simple-ee/Power_CircuitDesigns/Ideal Diode (LM5051 version)/20240805_Projects_Ideal_Diode_LM5051_version_01.jpg

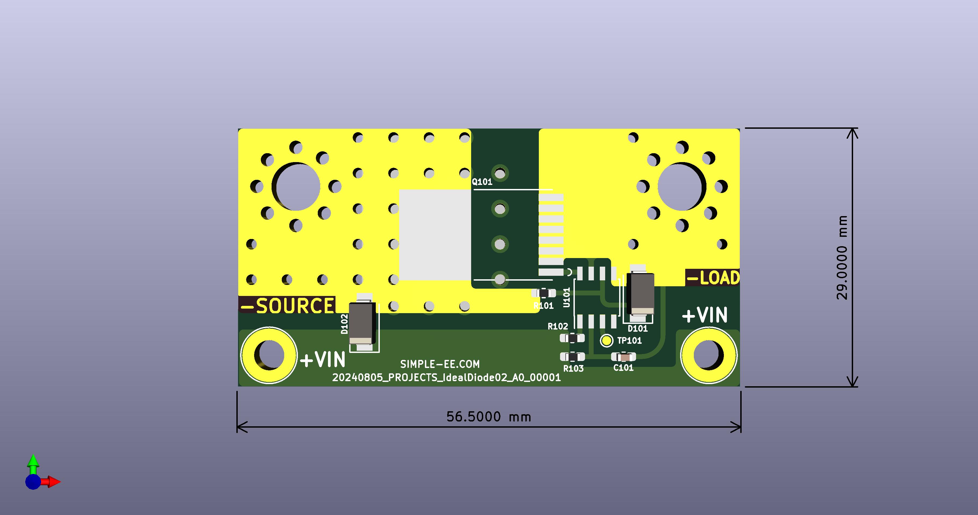
Ideal Diode (LM5051 version)/20240805_Projects_Ideal_Diode_LM5051_version_01.jpg
