simple-ee/Power_CircuitDesigns/Ideal Diode/2021_Project_OCP_Ideal_DiodeFront.jpg

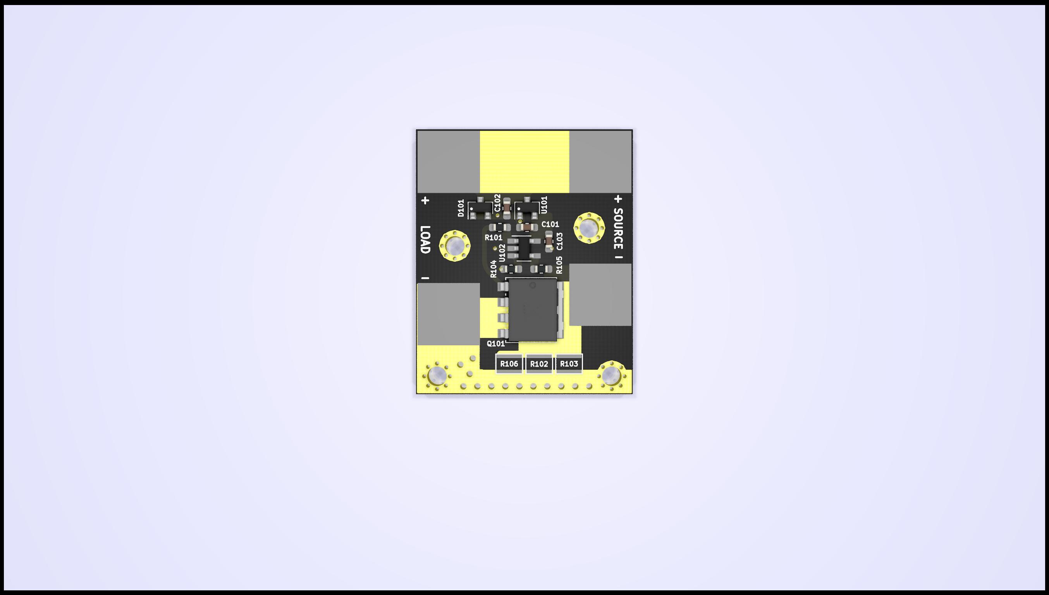
Ideal Diode/2021_Project_OCP_Ideal_DiodeFront.jpg
