simple-ee/Power_CircuitDesigns/Ideal Diode (LM5051 version)/Source Files/20220727_Projects_Ideal_Diode_02.step

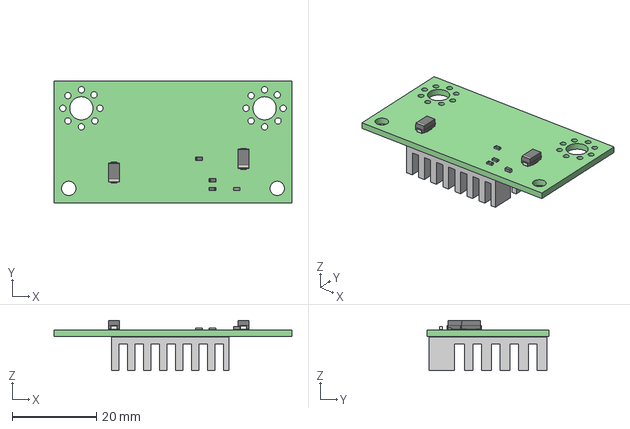
[picture p3: CAD file, 2024-08-06]
Ideal Diode (LM5051 version)/Source Files/20220727_Projects_Ideal_Diode_02.step
56.5 x 29.0 x 11.9 mm
20220727_Projects_Ideal_Diode_02 PCB
