simple-ee/Power_CircuitDesigns/Ideal Diode/Schematic_Gerber/2021_Project_OCP_Ideal_Diode_A4.pdf

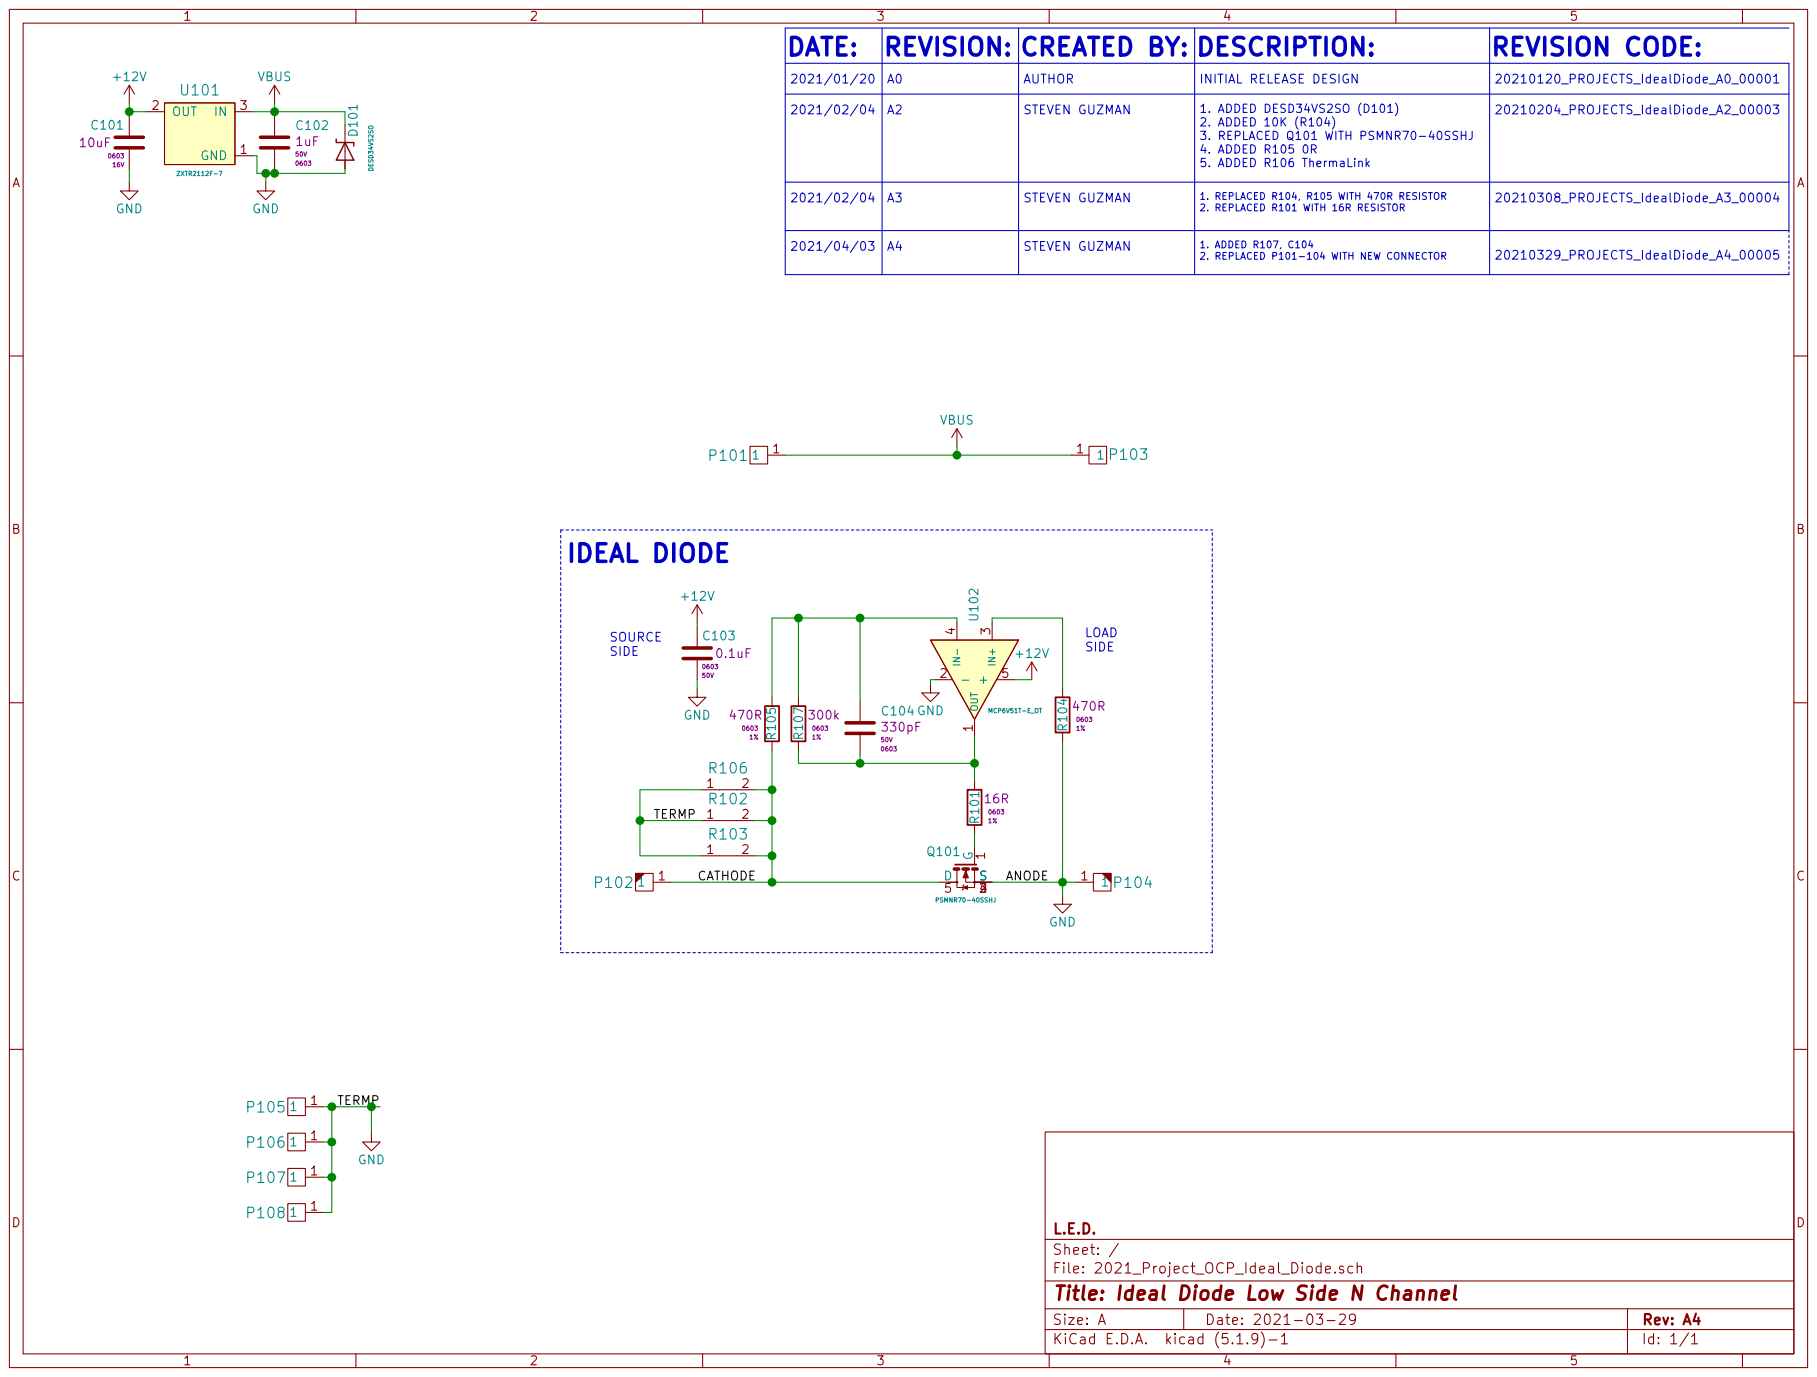
[picture p4: page 1]

2. REPLACED P101-104 WITH NEW CONNECTOR 1. ADDED DESD34VS2SO (D101) 2. ADDED 10K (R104) 3. REPLACED Q101 WITH PSMNR70-40SSHJ 4. ADDED R105 0R 5. ADDED R106 ThermaLink | 20210329_PROJECTS_IdealDiode_A4_00005 A0 20210120_PROJECTS_IdealDiode_A0_00001 STEVEN GUZMAN

AUTHOR | INITIAL RELEASE DESIGN

2021/02/04 | A3 | STEVEN GUZMAN | 1. REPLACED R104, R105 WITH 470R RESISTOR 2. REPLACED R101 WITH 16R RESISTOR | 20210308_PROJECTS_IdealDiode_A3_00004

2021/04/03 | A4 | | 1. ADDED R107, C104

Id: 1/1 Title: Ideal Diode Low Side N Channel
