simple-ee/Power_CircuitDesigns/Ideal Diode/Schematic_Gerber/2021_Project_OCP_Ideal_Diode_A3.pdf

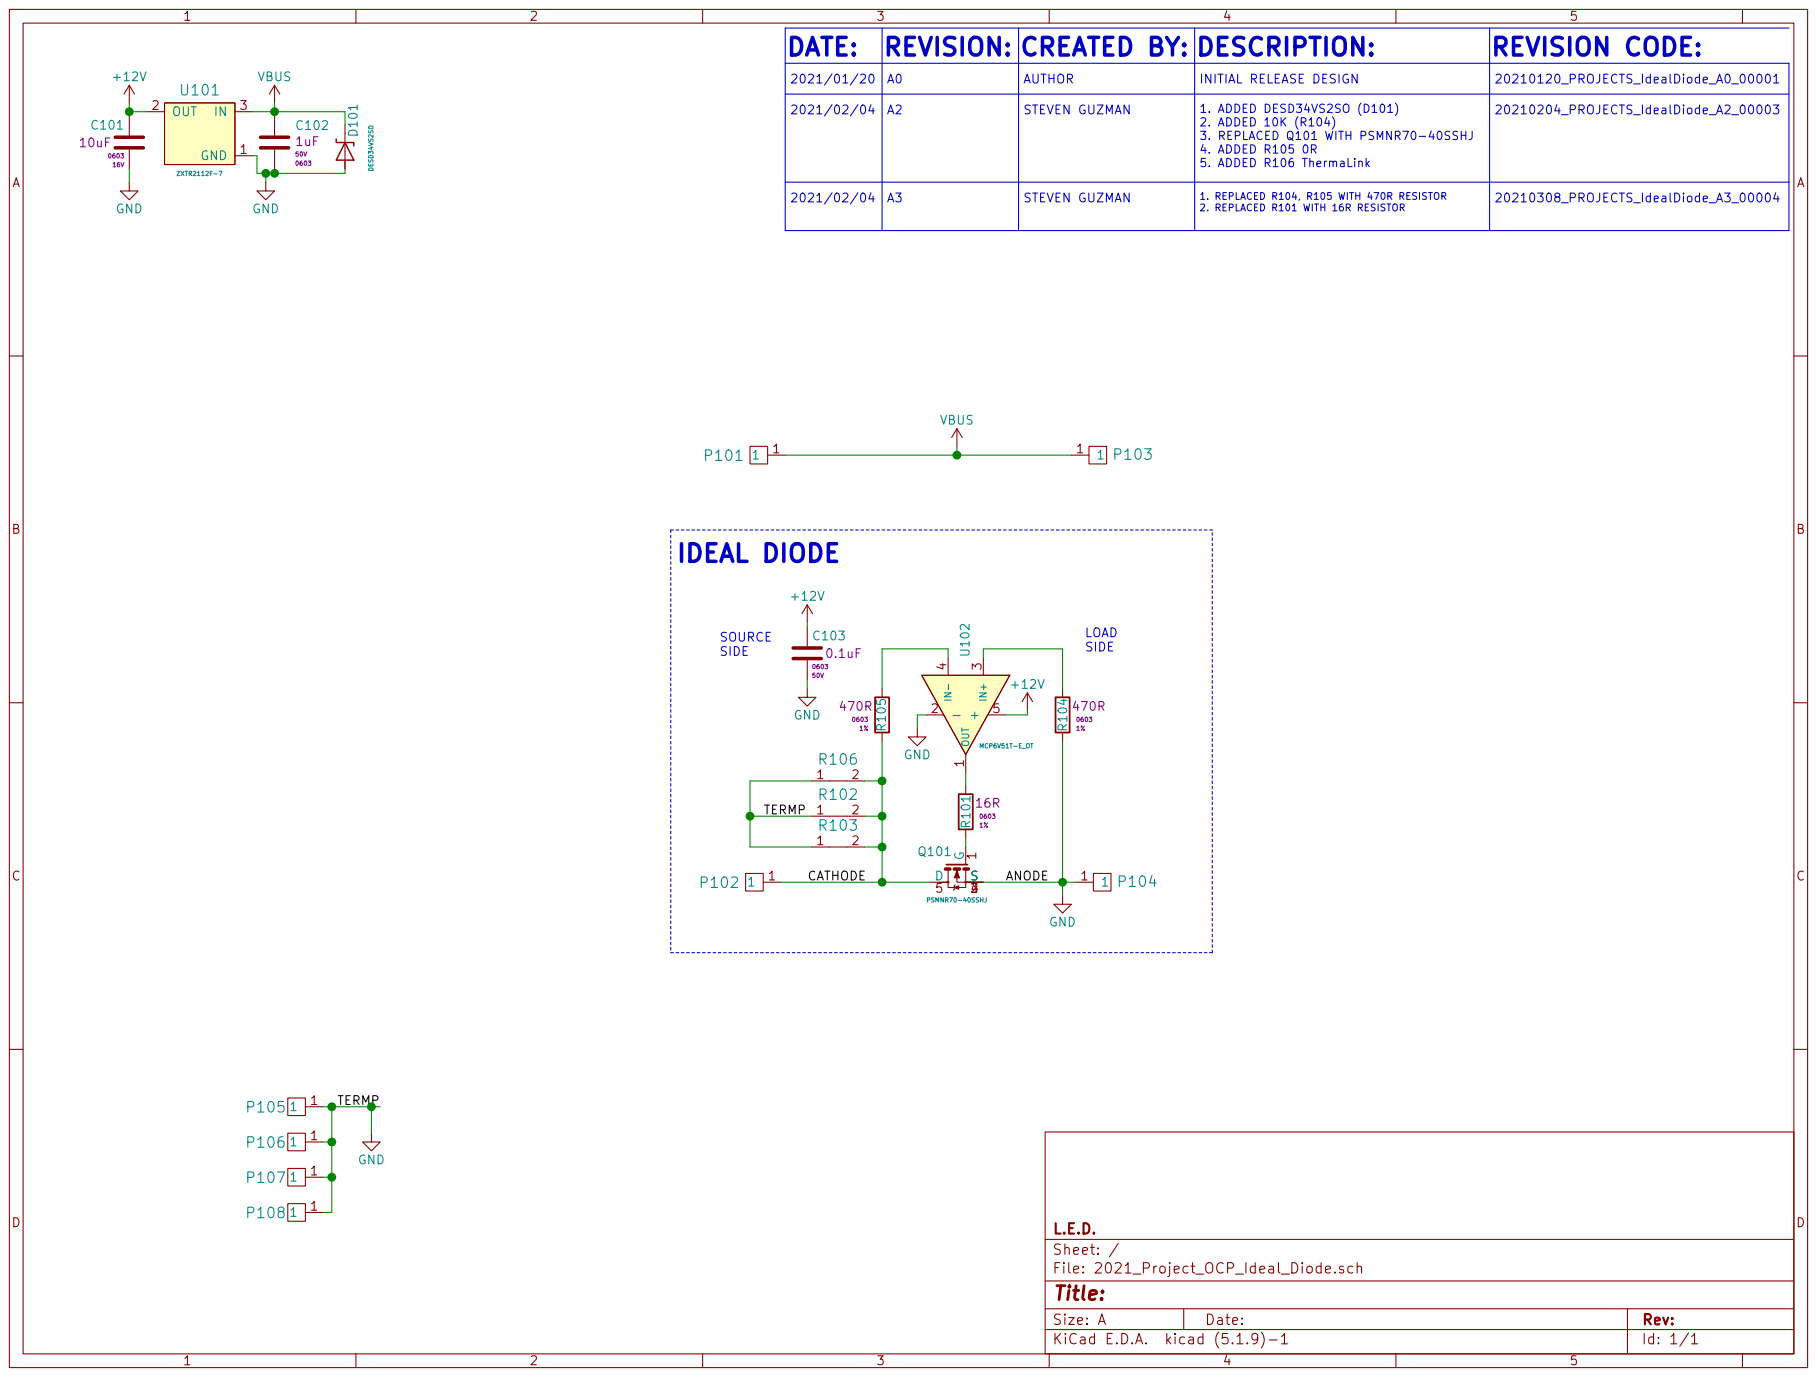
[picture p5: page 1]

REVISION: | STEVEN GUZMAN | DESCRIPTION: A3 INITIAL RELEASE DESIGN | REVISION CODE: 20210308_PROJECTS_IdealDiode_A3_00004 DATE:

2021/02/04 | A2 | | 2. REPLACED R101 WITH 16R RESISTOR STEVEN GUZMAN 1. ADDED DESD34VS2SO (D101) 2. ADDED 10K (R104) 3. REPLACED Q101 WITH PSMNR70-40SSHJ 4. ADDED R105 0R | 20210204_PROJECTS_IdealDiode_A2_00003

5. ADDED R106 ThermaLink IDEAL DIODE

1. REPLACED R104, R105 WITH 470R RESISTOR
