simple-ee/Power_CircuitDesigns/Ideal Diode (LM5051 version)/20240805_Projects_Ideal_Diode_LM5051_version_01.pdf

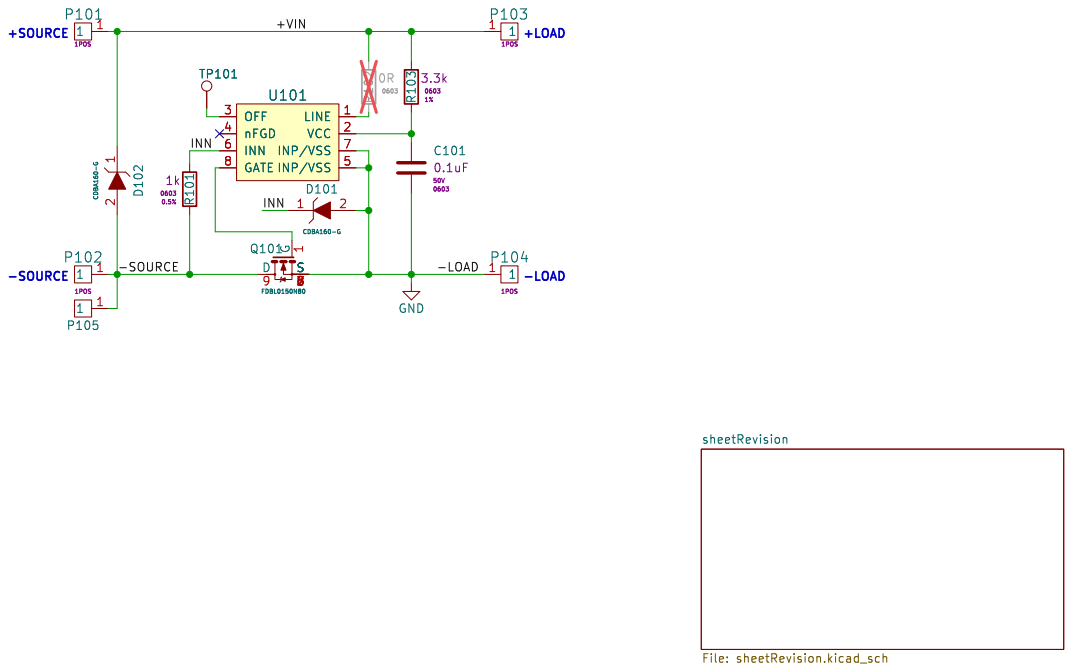
[picture p6: page 1]

Id: 1/2 Title: File: 20220727_Projects_Ideal_Diode_02.kicad_sch Sheet: / simple-ee.com

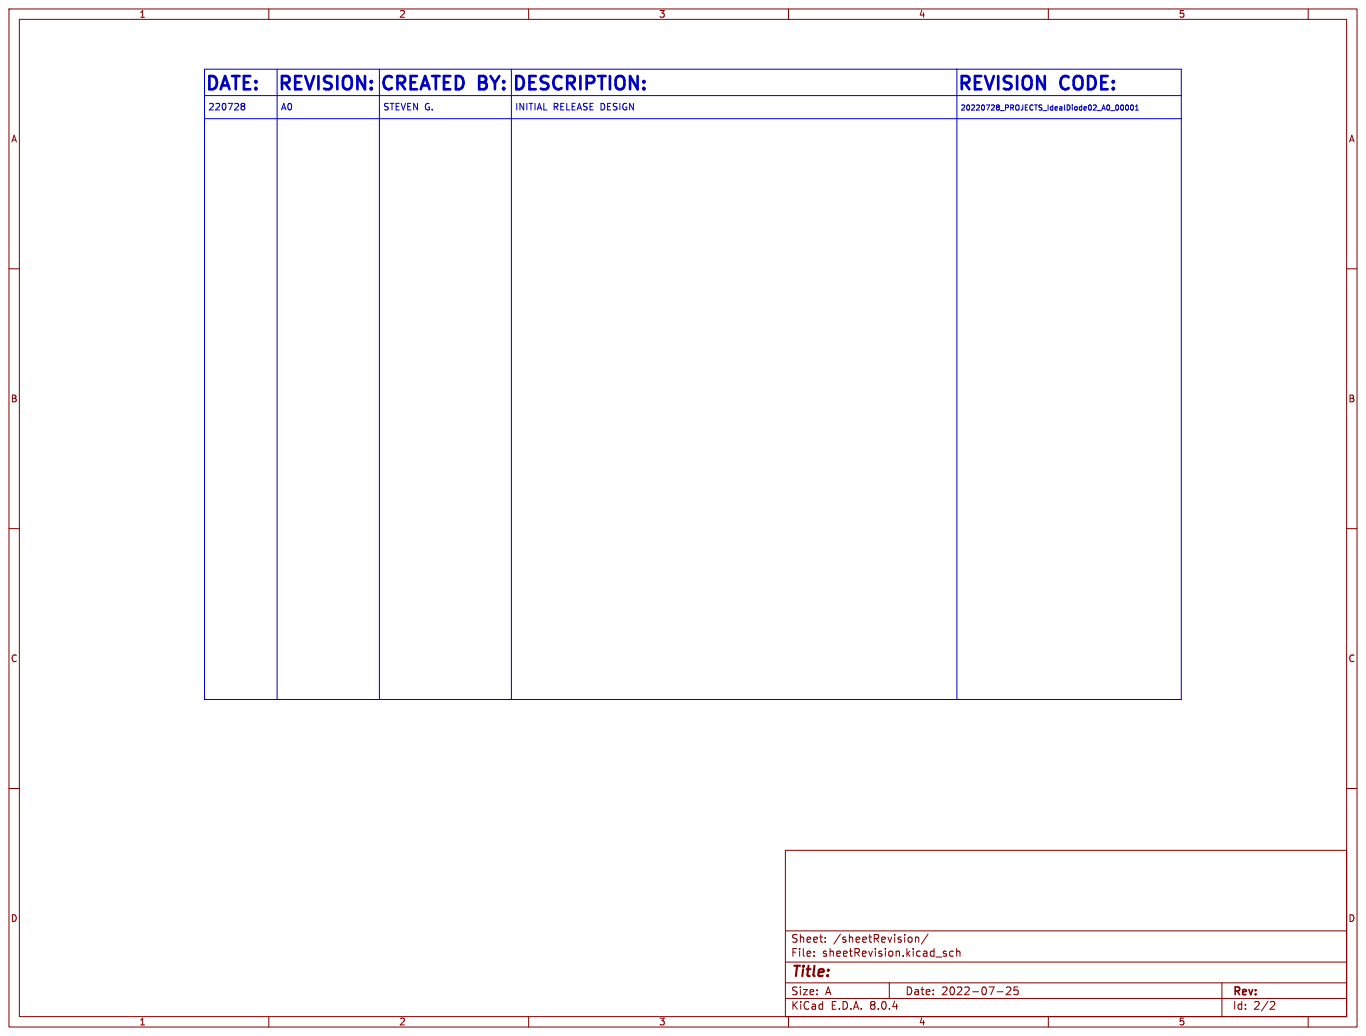
[picture p7: page 2]

Id: 2/2 Title: File: sheetRevision.kicad_sch Sheet: /sheetRevision/ DATE:
