simple-ee/Power_CircuitDesigns/Ideal Diode/Schematic_Gerber/2021_Project_OCP_Ideal_Diode.pdf

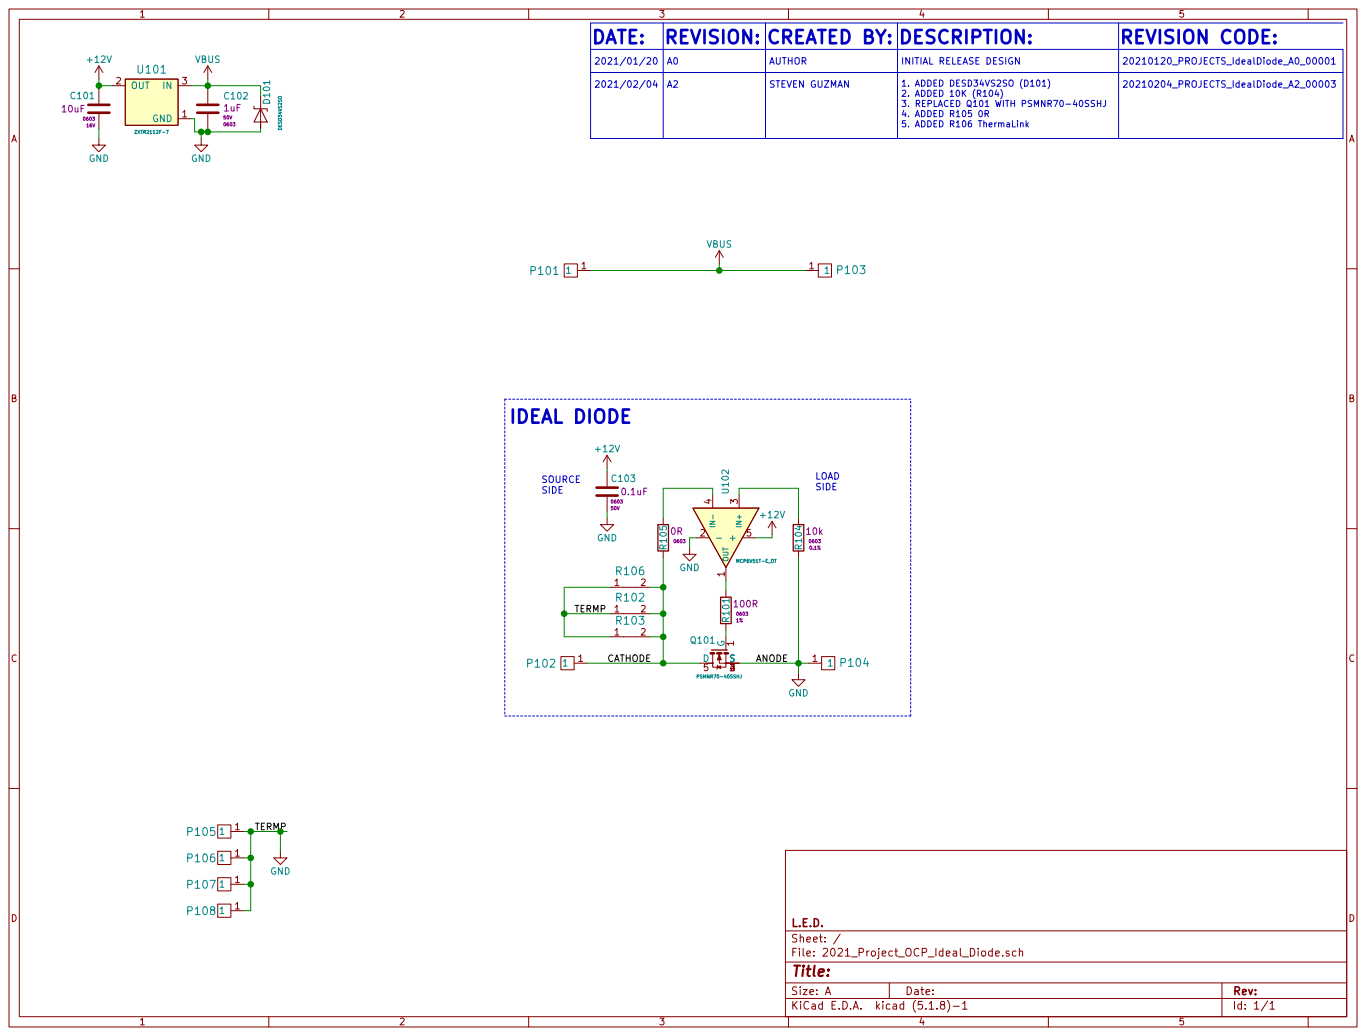
[picture p8: page 1]

5. ADDED R106 ThermaLink 1. ADDED DESD34VS2SO (D101) 2. ADDED 10K (R104) 3. REPLACED Q101 WITH PSMNR70-40SSHJ 4. ADDED R105 0R | 20210120_PROJECTS_IdealDiode_A0_00001
