simple-ee/Power_CircuitDesigns/Ideal Diode (LM5051 version)/Source Files/20220727_Projects_Ideal_Diode_02.kicad_pcb

## KiCad design Ideal Diode (LM5051 version)/Source Files/20220727_Projects_Ideal_Diode_02.kicad_pcb (2024-08-06)

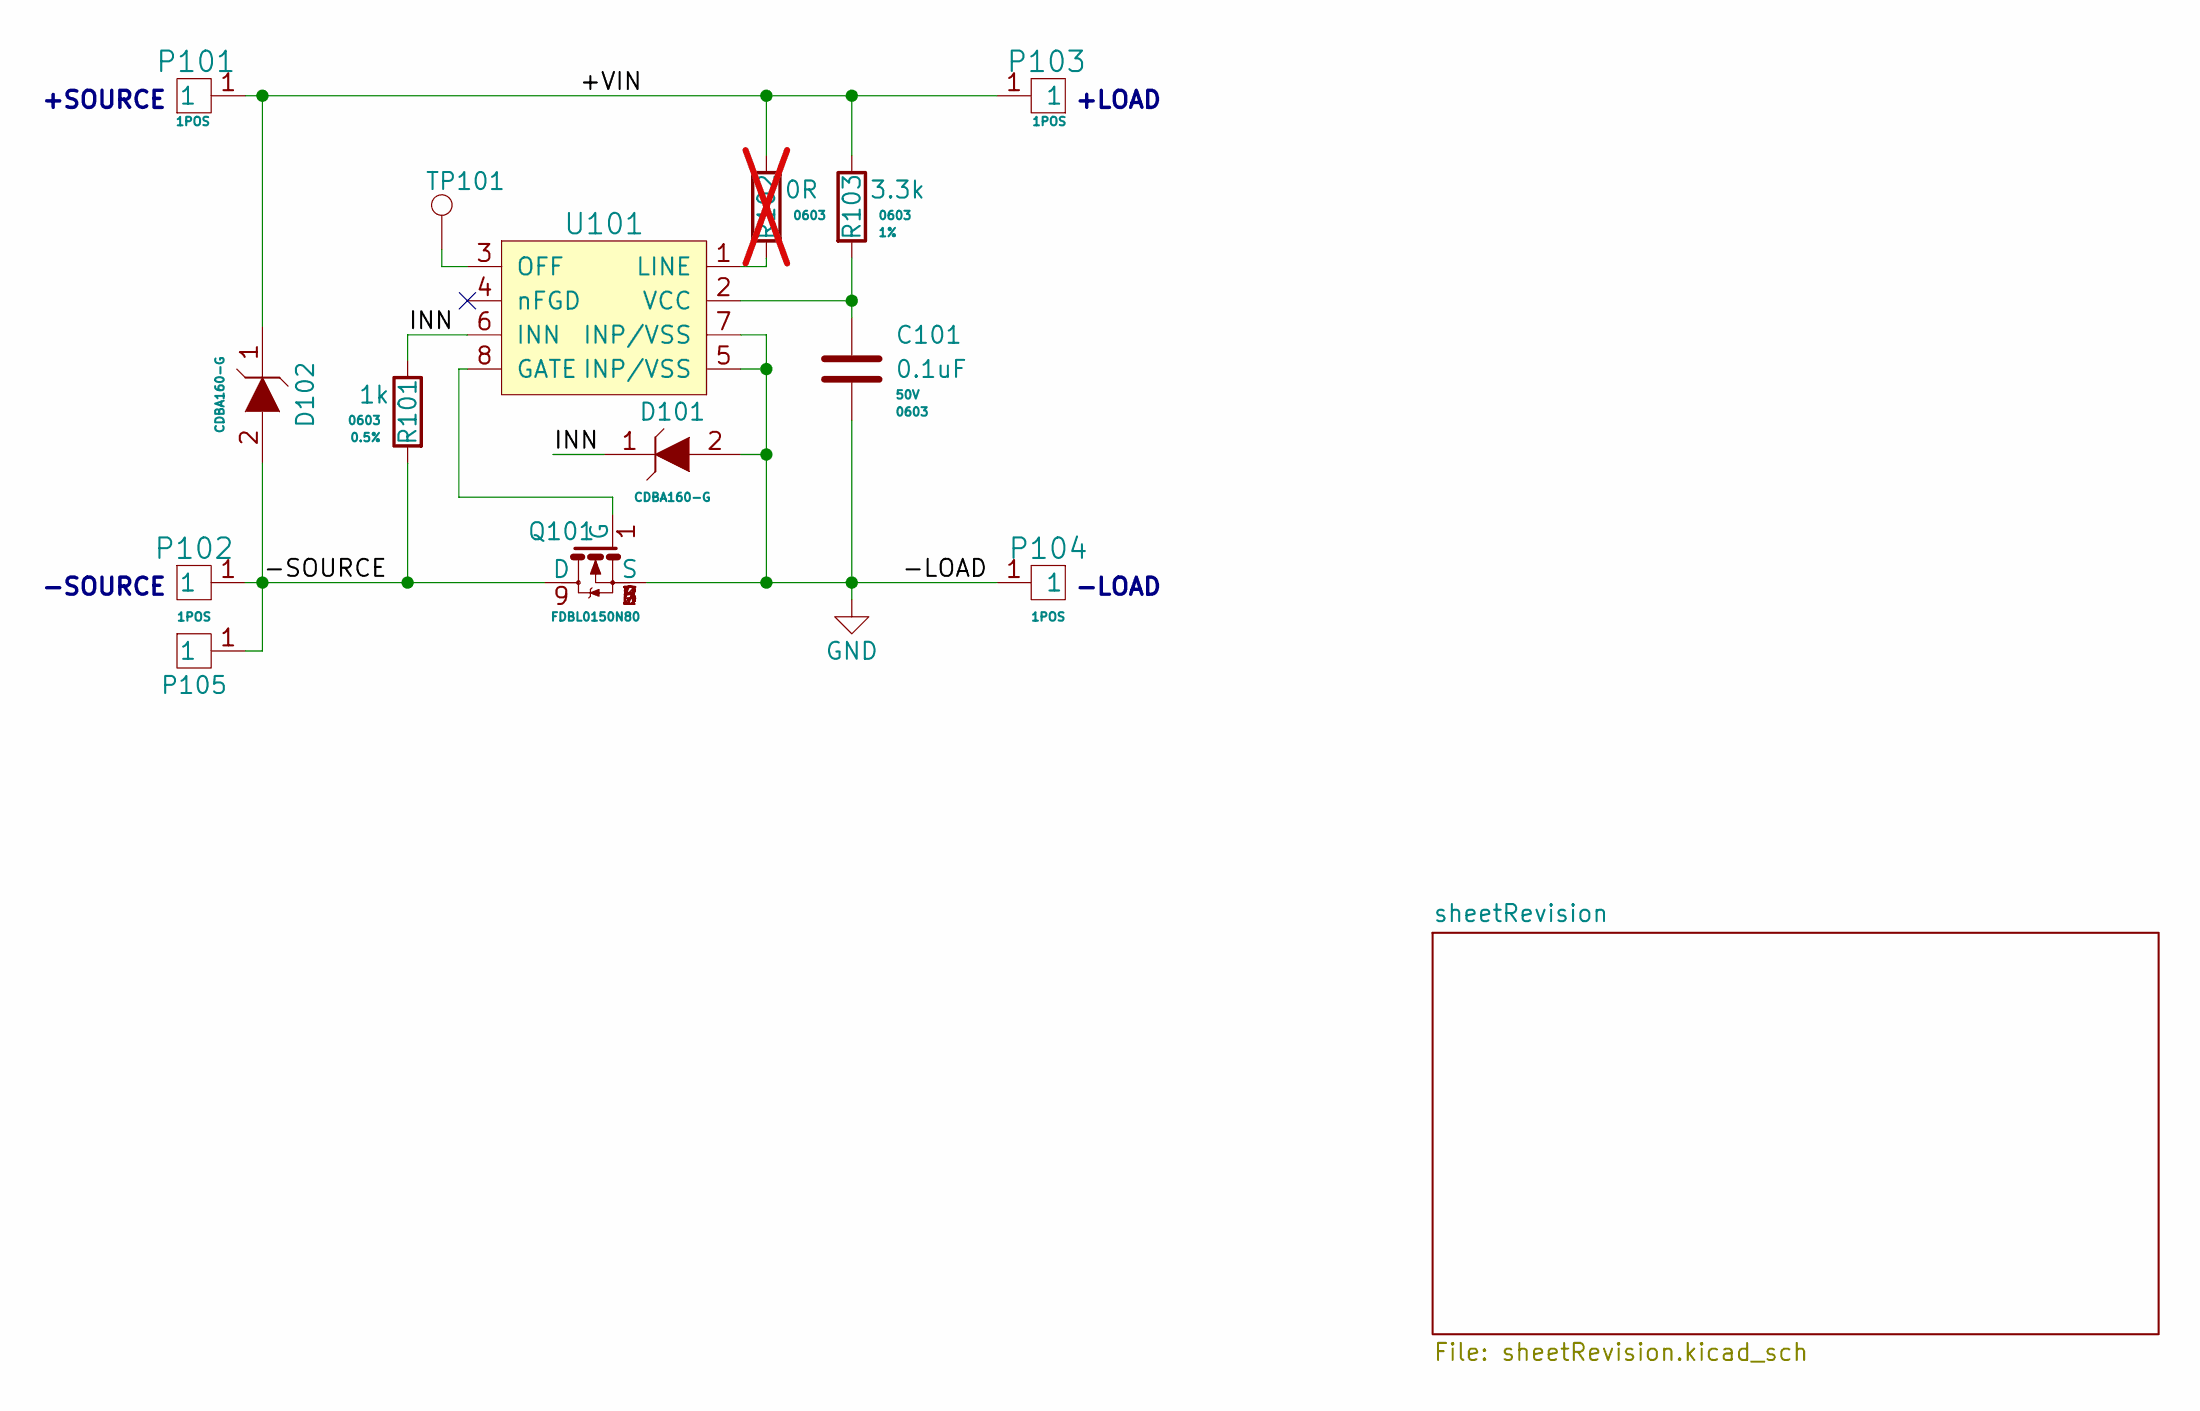
[picture p9: schematic 20220727_Projects_Ideal_Diode_02.kicad_sch]

Parts:
C101: C0603C104K5RACAUTO; C_0603_Handsolder
D101, D102: CDBA160-G; D_SMA
P101, P103: TH_1POS_3.4MM_M3; TH_1POS_3.4MMxM3
P102, P104: TH_1POS_12MM_M5; TH_1POS_12MMxM5
P105: Heatsink_28x28x10mm; Manufacturer ###
Q101: FDBL0150N80; HPSOF-8
R101: RR0816P-102-D; R_0603_Handsolder
R102: RMCF0603ZT0R00; R_0603_Handsolder; not fitted
R103: RC0603FR-073K3L; R_0603_Handsolder
TP101: TestPoint_D1MM; TestPoint_Pad_D1.0mm
U101: LM5051MAX_NOPB; SOIC-8

Connections:
/+VIN: D102.1 (K), P101.1, P103.1, R102.1, R103.1
/-SOURCE: D102.2 (A), P102.1, P105.1, Q101.9 (D), R101.2
/INN: D101.1 (K), R101.1, U101.6 (INN)
GND: C101.2, D101.2 (A), P104.1, Q101.2 (S), Q101.3 (S), Q101.4 (S), Q101.5 (S), Q101.6 (S), Q101.7 (S), Q101.8 (S), U101.5 (INP/VSS), U101.7 (INP/VSS)
unnamed: Q101.1 (G), U101.8 (GATE)
unnamed: R102.2, U101.1 (LINE)
unnamed: TP101.1, U101.3 (OFF)
unnamed: C101.1, R103.2, U101.2 (VCC)

Notes on the sheet:
-LOAD
+LOAD
-SOURCE
+SOURCE

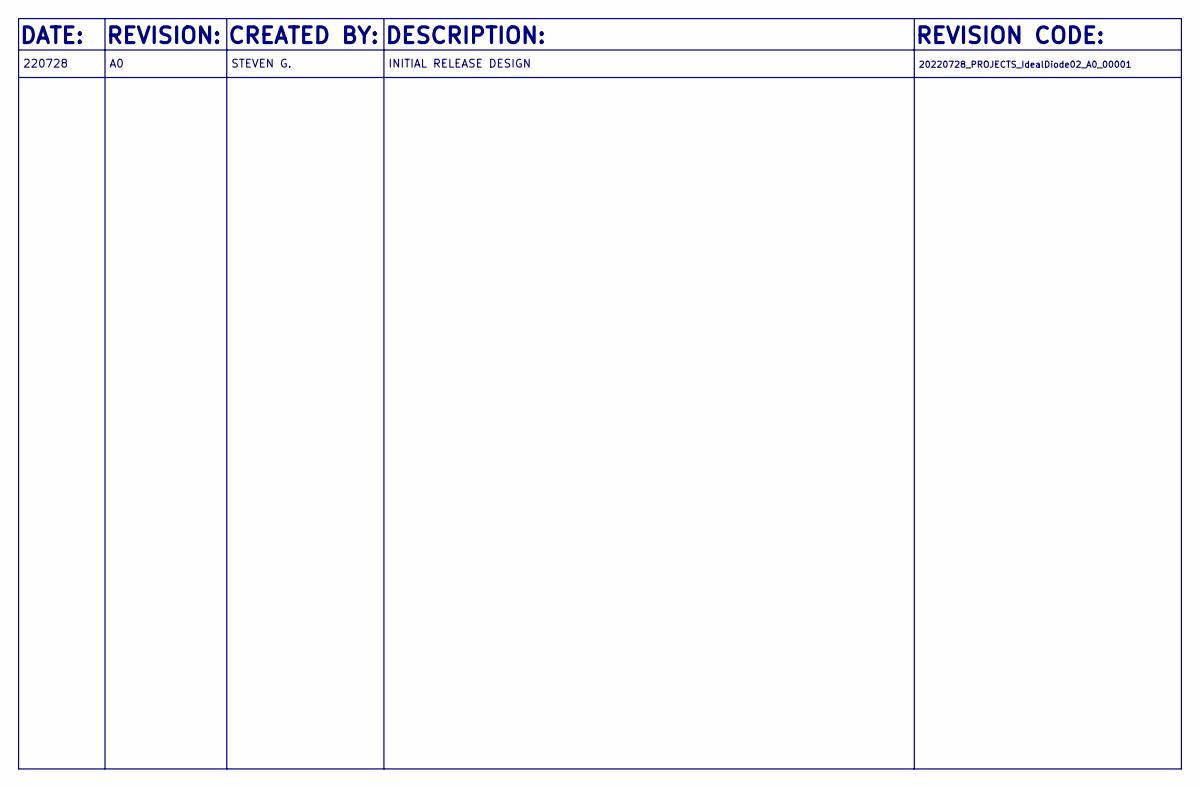
[picture p10: schematic sheetRevision.kicad_sch]

Notes on the sheet:
INITIAL RELEASE DESIGN
20220728_PROJECTS_IdealDiode02_A0_00001
220728
REVISION:
STEVEN G.
REVISION CODE:
DESCRIPTION:
DATE:
CREATED BY:

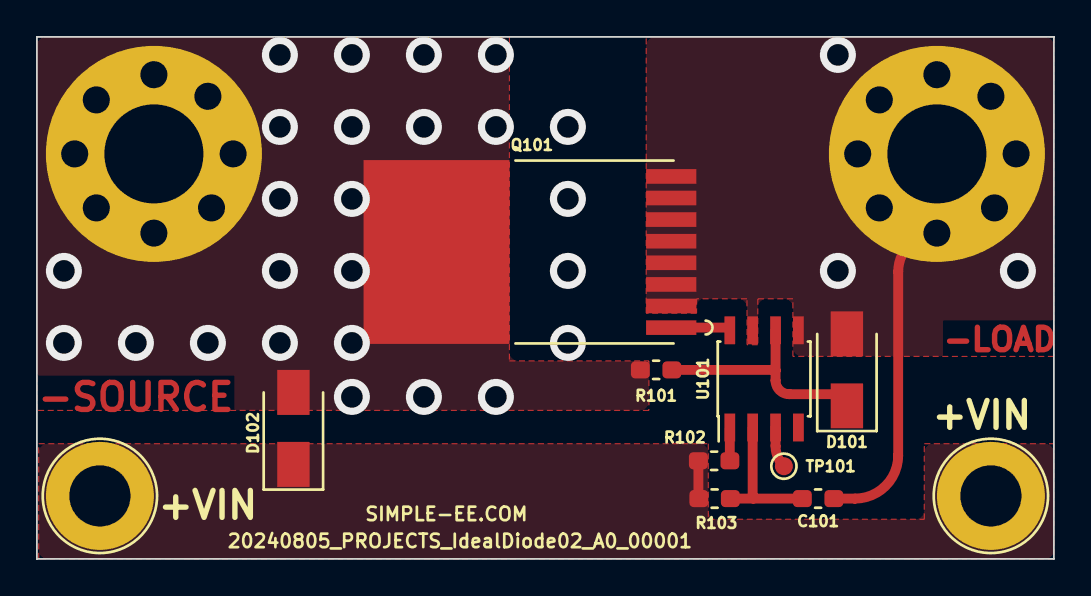
[picture p11: board 20220727_Projects_Ideal_Diode_02.kicad_pcb from above]

Board: 2 copper layers, 56.5 x 29.0 mm, 14 parts (1 on the bottom side), 8 nets.
