simple-ee/Power_CircuitDesigns/Ideal Diode/Source Files/2021_Project_OCP_Ideal_Diode.kicad_pcb

## KiCad design Ideal Diode/Source Files/2021_Project_OCP_Ideal_Diode.kicad_pcb (2021-05-03)

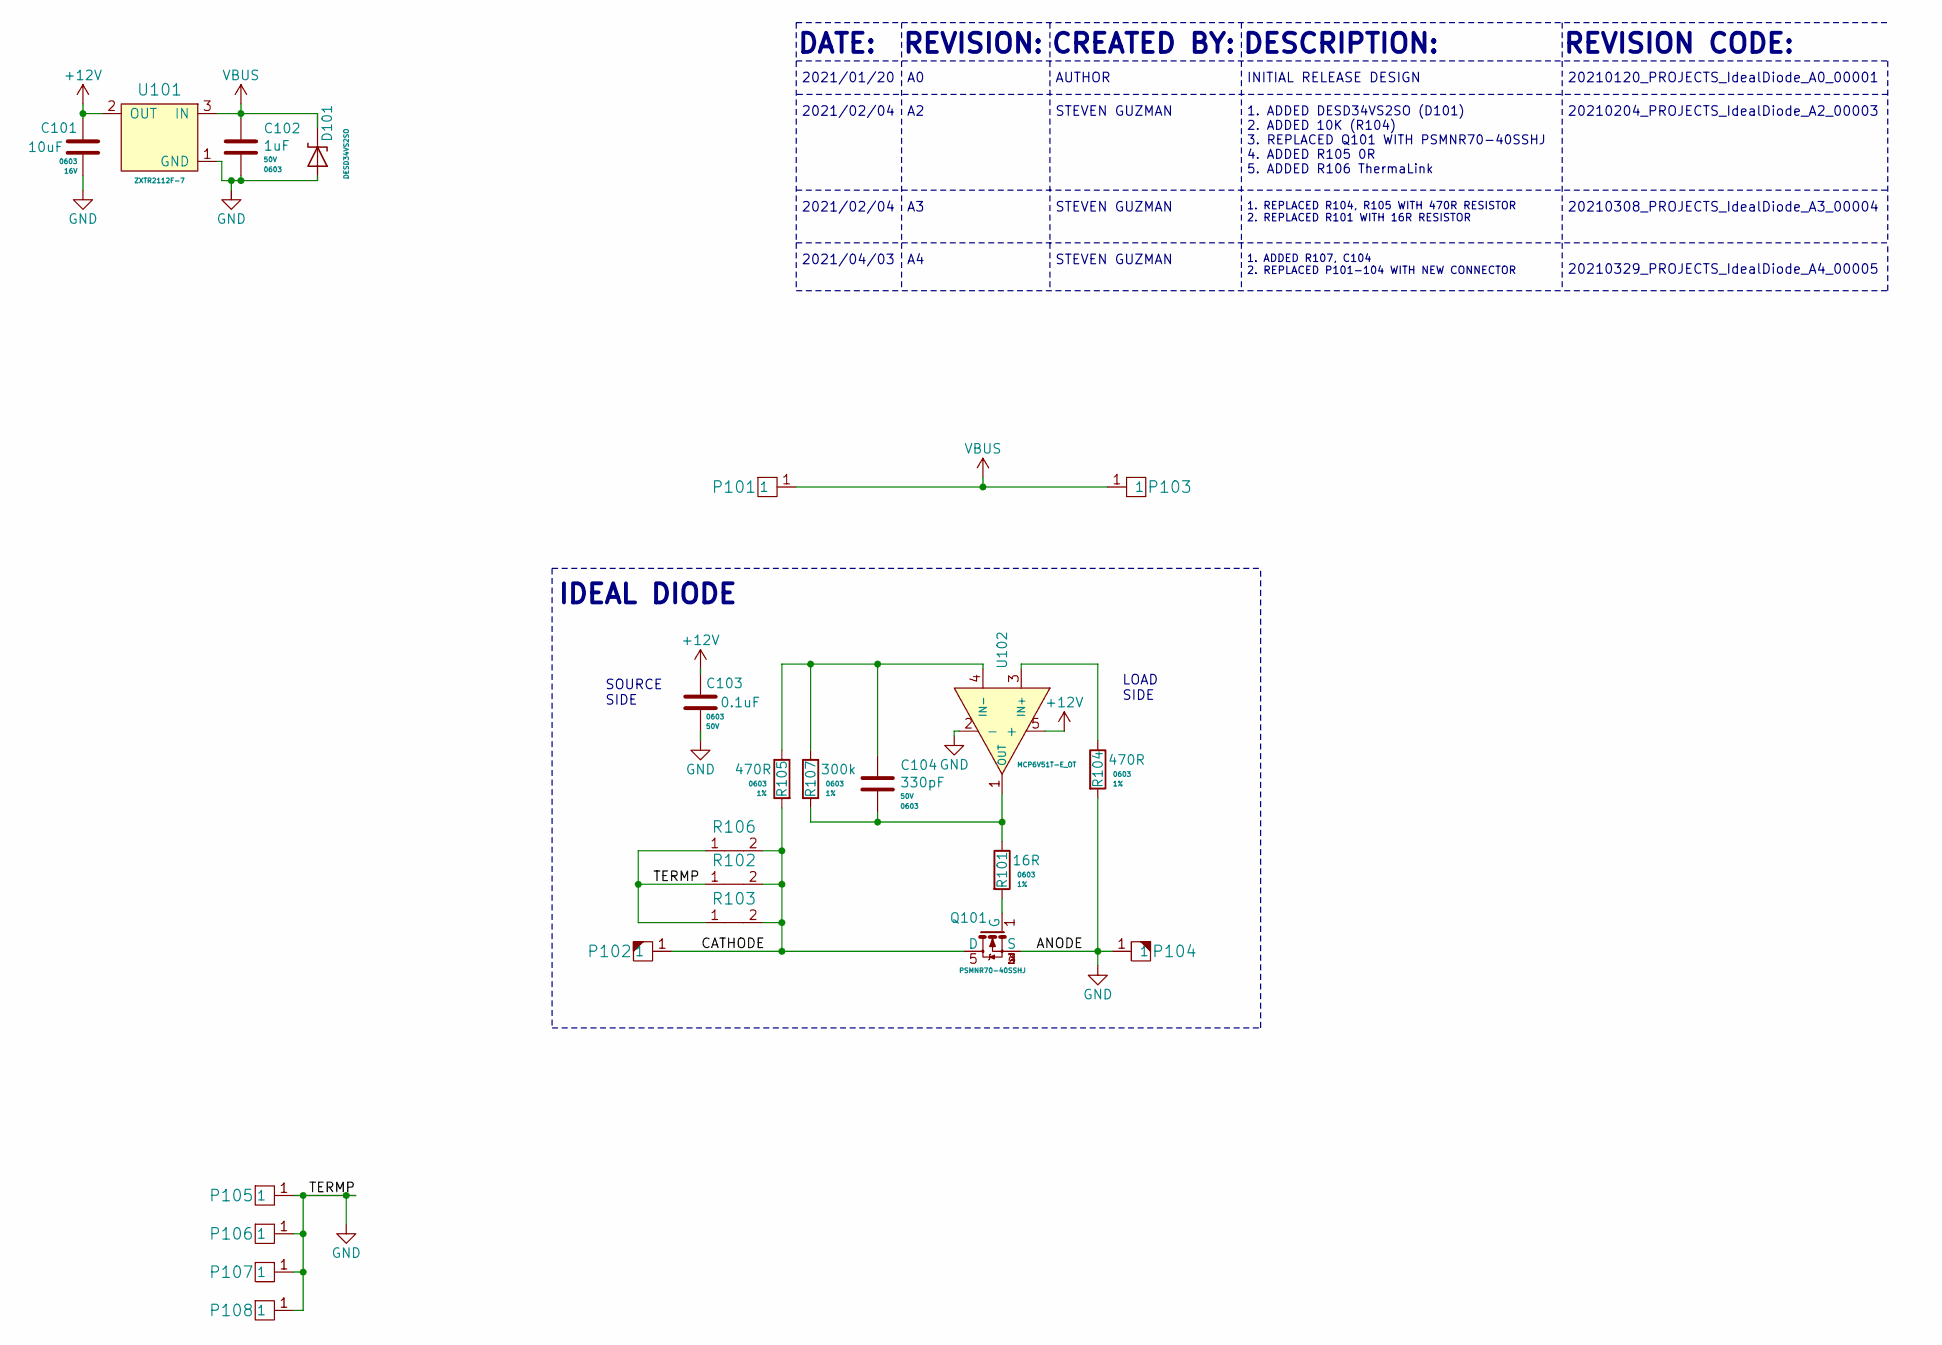
[picture p12: schematic 2021_Project_OCP_Ideal_Diode.sch, Ideal Diode Low Side N Channel]

Parts:
C101: CL10X106MO8NRNC; C_0603_Handsolder
C102: CL10A105KB8NNNC; C_0603_Handsolder
C103: C0603C104K5RACAUTO; C_0603_Handsolder
C104: C0603C331J5GACTU; C_0603_Handsolder
D101: DESD34VS2SO; SOT-23-3
P101, P103: 2.5x2.5mm_pad; pad_2.5x2.5mm
P102, P104: 7460305; 7460305_HASL
P105, P106, P107, P108: MH_1POS_2.5MM; MountingHole_2.5mm_Pad_Via
Q101: PSMNR70-40SSHJ; SOT-1235
R101: RC0603FR-0716RL; R_0603_Handsolder
R102, R103, R106: THJP0612AST1
R104, R105: RC0603FR-07470RL; R_0603_Handsolder
R107: RMCF0603FT300K; R_0603_Handsolder
U101: ZXTR2112F-7; SOT-23-3
U102: MCP6V51T-E_OT; SOT-23-5_HandSoldering

Connections:
+12V: C101.1, C103.1, U101.2 (OUT), U102.5 (+)
/CATHODE: P102.1, Q101.5 (D), R102.2, R103.2, R105.2, R106.2
GND: C101.2, C102.2, C103.2, D101.1 (A), D101.2 (A), P104.1, P105.1, P106.1, P107.1, P108.1, Q101.2 (S), Q101.3 (S), Q101.4 (S), R102.1, R103.1, R104.2, R106.1, U101.1 (GND), U102.2 (-)
unnamed: C104.1, R105.1, R107.1, U102.4 (IN-)
unnamed: C104.2, R101.1, R107.2, U102.1 (OUT)
unnamed: Q101.1 (G), R101.2
unnamed: R104.1, U102.3 (IN+)
VBUS: C102.1, D101.3 (K), P101.1, P103.1, U101.3 (IN)

Notes on the sheet:
DATE:
DESCRIPTION:
REVISION:
REVISION CODE:
2021/01/20
CREATED BY:
AUTHOR
20210120_PROJECTS_IdealDiode_A0_00001
SOURCE SIDE
LOAD SIDE
INITIAL RELEASE DESIGN
IDEAL DIODE
1. ADDED DESD34VS2SO (D101) 2. ADDED 10K (R104) 3. REPLACED Q101 WITH PSMNR70-40SSHJ 4. ADDED R105 0R 5. ADDED R106 ThermaLink
2021/02/04
20210204_PROJECTS_IdealDiode_A2_00003
STEVEN GUZMAN
1. REPLACED R104, R105 WITH 470R RESISTOR 2. REPLACED R101 WITH 16R RESISTOR
20210308_PROJECTS_IdealDiode_A3_00004
2021/04/03
1. ADDED R107, C104 2. REPLACED P101-104 WITH NEW CONNECTOR
20210329_PROJECTS_IdealDiode_A4_00005

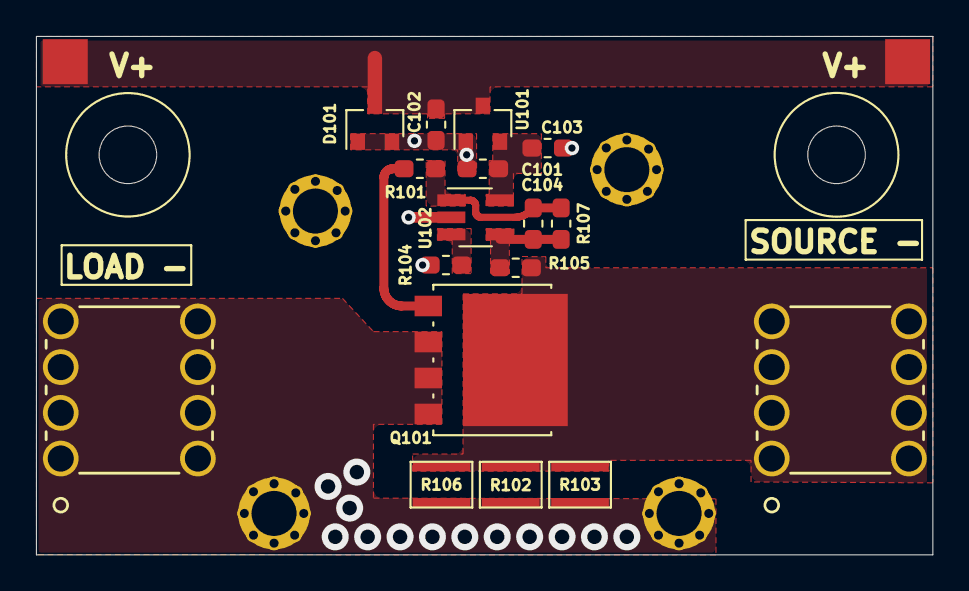
[picture p13: board 2021_Project_OCP_Ideal_Diode.kicad_pcb from above]

Board: 2 copper layers, 49.8 x 28.8 mm, 23 parts (0 on the bottom side), 8 nets.
