simple-ee/Power_CircuitDesigns/(commit log)

2021-02-15 Create Ideal Diode
2021-03-08 Add files via upload
    Version 3 release:
    1. Updated R104 and R105 to 470R resistor value for better reverse current protection
    2. Updated R101 for better stability when in reverse current when using a switch mode power supply as the source. Higher switching frequencies in reverse current condition causes oscillation in the op amp. This was not an issue when using a battery as the source since there are no switching frequencies that causes instability.
2021-05-03 Version A4
    Updated to Version A4 of ideal diode
    [2021_Project_OCP_Ideal_Diode.kicad_pcb, 2021_Project_OCP_Ideal_Diode.sch, 2021_Project_OCP_Ideal_Diode_.csv]
2024-08-06 New version using LM5051 from texas instrument
    This is an updated version of the ideal diode using LM5051. The last version was a discrete version using a zero-drift op amp and will later update that version as well but for a quick solution and lower part count, this version was created.
    [20220727_Projects_Ideal_Diode_02-B_Mask.gbs, 20220727_Projects_Ideal_Diode_02-B_Paste.gbp, 20220727_Projects_Ideal_Diode_02-B_Silkscreen.gbo, 20220727_Projects_Ideal_Diode_02-BotLayer.gbl, 20220727_Projects_Ideal_Diode_02-Edge_Cuts.gm1, 20220727_Projects_Ideal_Diode_02-F_Mask.gts, 20220727_Projects_Ideal_Diode_02-F_Paste.gtp, 20220727_Projects_Ideal_Diode_02-F_Silkscreen.gto]
